atuy/Arduino_Intruder_Detection_System/회로도.png

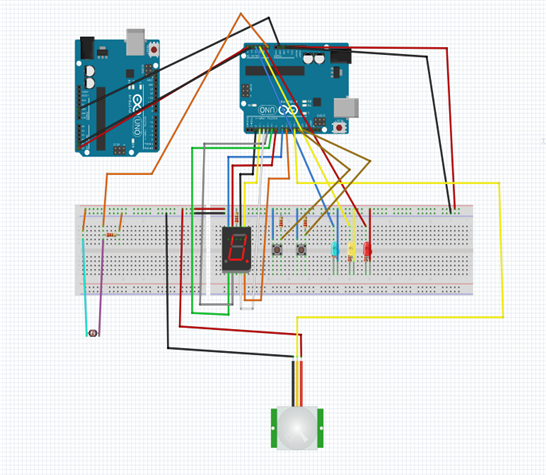
회로도.png
